chin-5-may/Analog-Computer/Screenshot 2025-04-14 124705.png

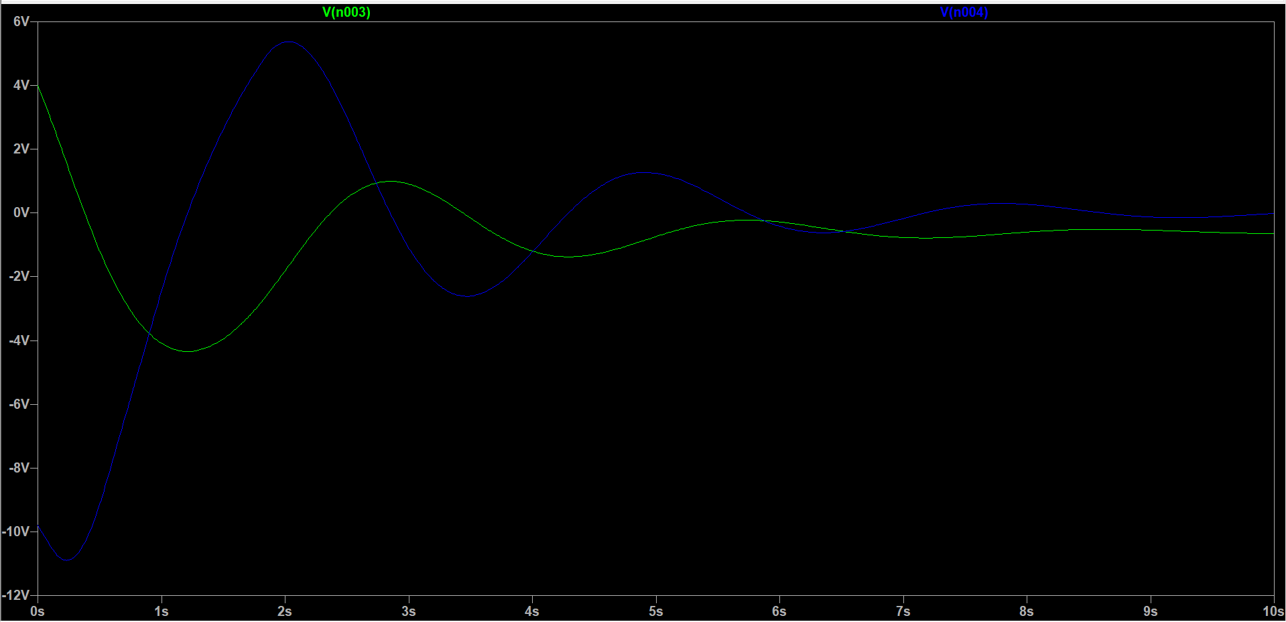
Screenshot 2025-04-14 124705.png
