chin-5-may/Analog-Computer/analog_computer.asc

C1: cap; 100µ; ic=10.1
C2: cap; 100µ; ic=17
g: voltage; 3
R1: res; 20k
R2: res; 20k
R3: res; 20k
R4: res; 20k
R5: res; 20k
R6: res; 20k
R7: res; 20k
R8: res; 20k
R9: res; 10k
R14: res; 10k
R15: res; 10k
R16: res; 10k
R17: res; 10k
R94: res; 40k
U7: TL084
U8: TL084
U9: TL084
U10: TL084
U11: TL084
U12: TL084
V1: voltage; 15
V2: voltage; 15
V3: voltage; -15
V4: voltage; -15
V5: voltage; 15
V6: voltage; 15
Named nets: 0
.tran 10
