chin-5-may/Analog-Computer/damped_freefall.asc

C1: cap; 100µ; ic=19.9
C2: cap; 100µ; ic=17
g1: voltage; 9.8
R1: res; 10k
R2: res; 10k
R3: res; 20k
R4: res; 20k
R5: res; 10k
R6: res; 10k
R7: res; 20k
R8: res; 20k
R11: res; 5k
R12: res; 5k
R14: res; 5k
U1: TL084
U2: TL084
U3: TL084
U4: TL084
U6: TL084
V1: voltage; 15
V2: voltage; 15
Named nets: 0
.tran 0 10 0 0.1
